Stopka/gimbal/README.md

# 3 axis gimbal
Hand held gimbal for Gopro Hero 3/4 camera with backpack display.

* [Parts](./docs/parts.md)
* [License](./LICENSE.md)

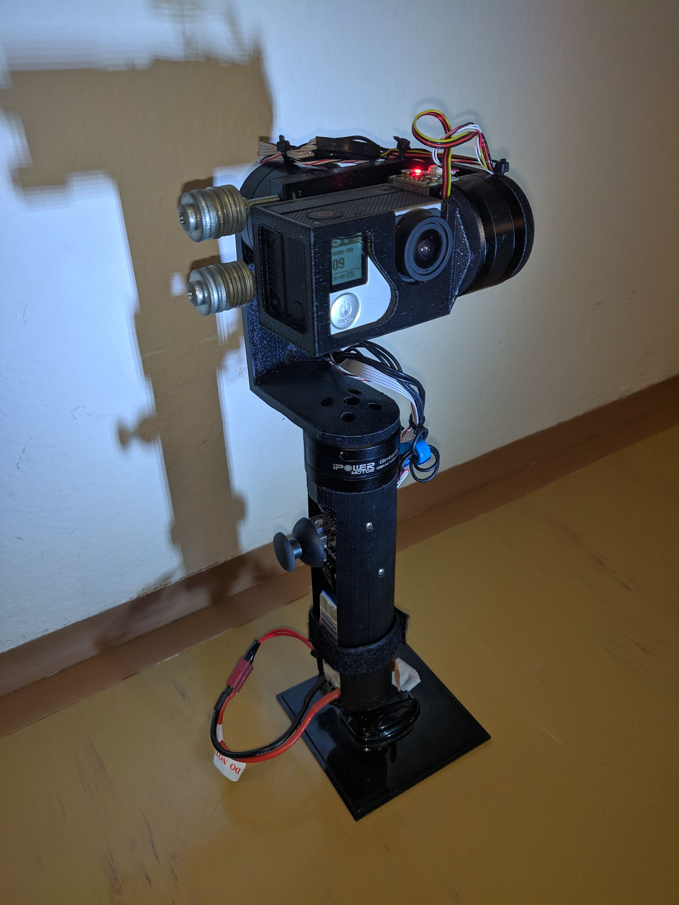
[picture p1: graphics/Image10.jpg]
