Stopka/gimbal/graphics/Image01.jpg

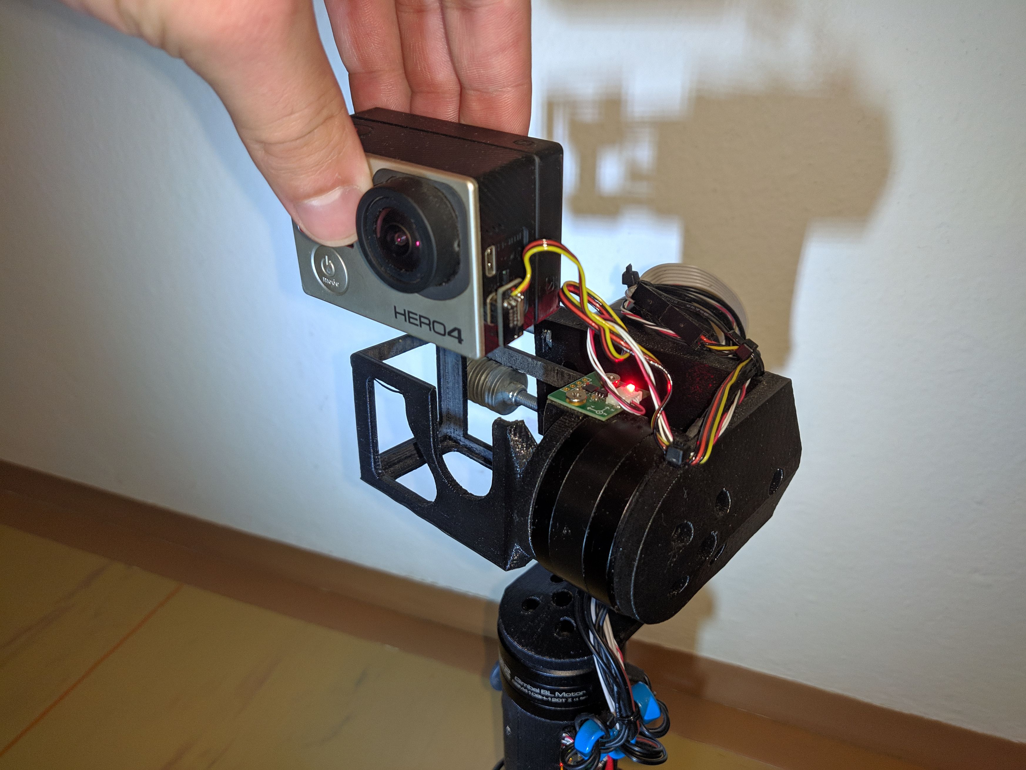
graphics/Image01.jpg
