Stopka/gimbal/graphics/Image02.jpg

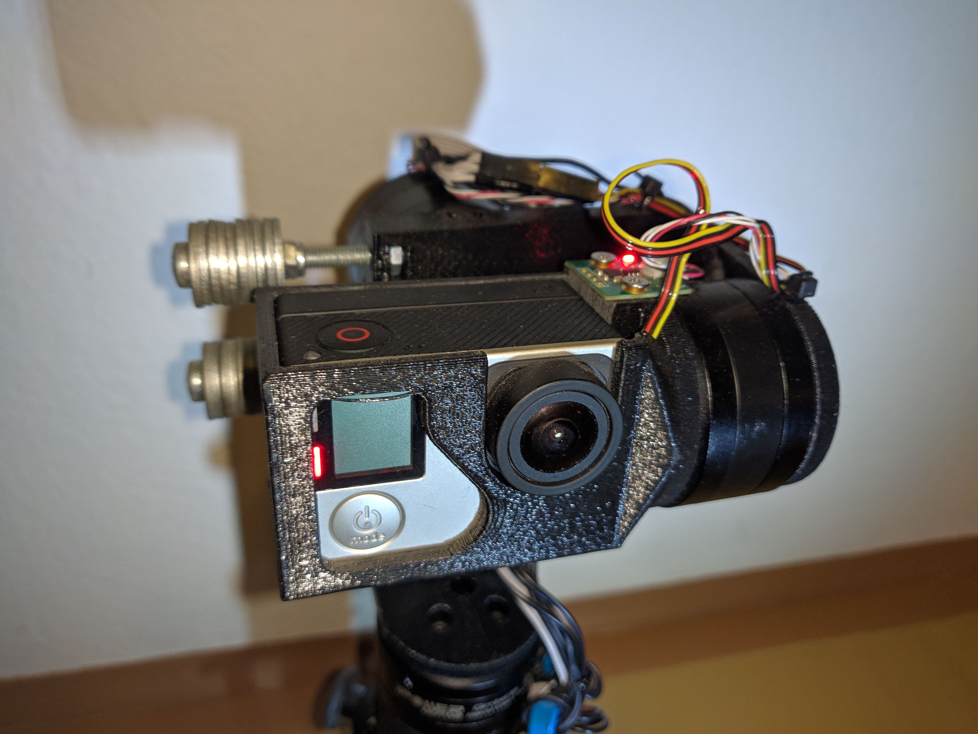
graphics/Image02.jpg
