Stopka/gimbal/graphics/Image03.jpg

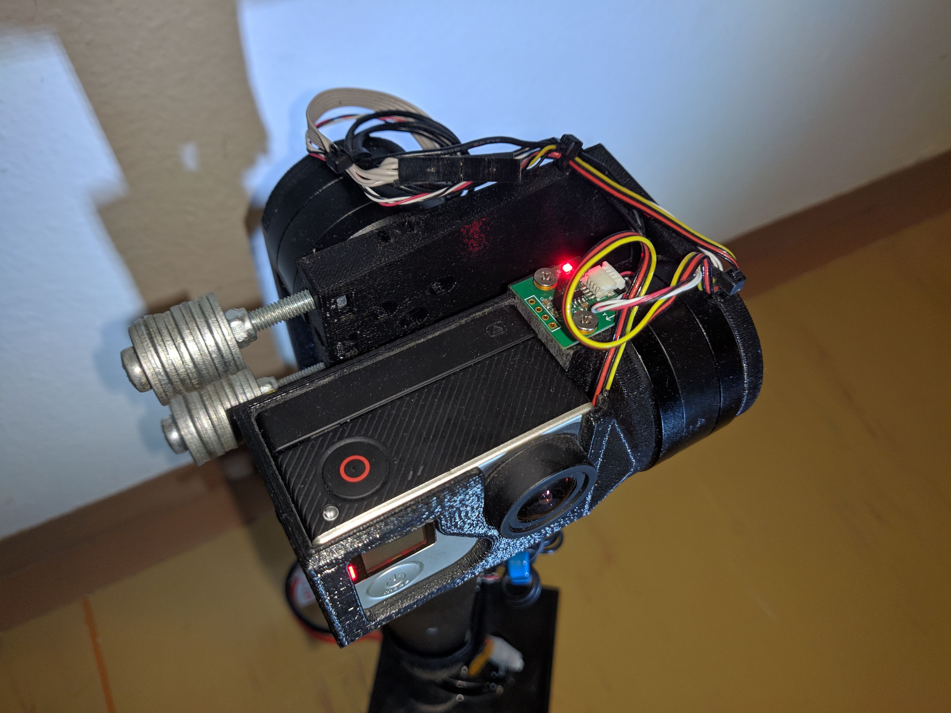
graphics/Image03.jpg
