Stopka/gimbal/graphics/Image04.jpg

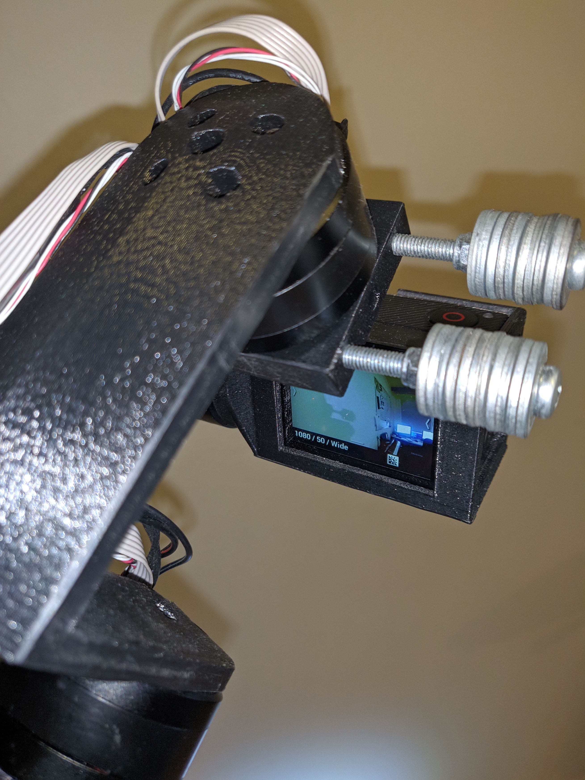
graphics/Image04.jpg
