Stopka/gimbal/graphics/Image05.jpg

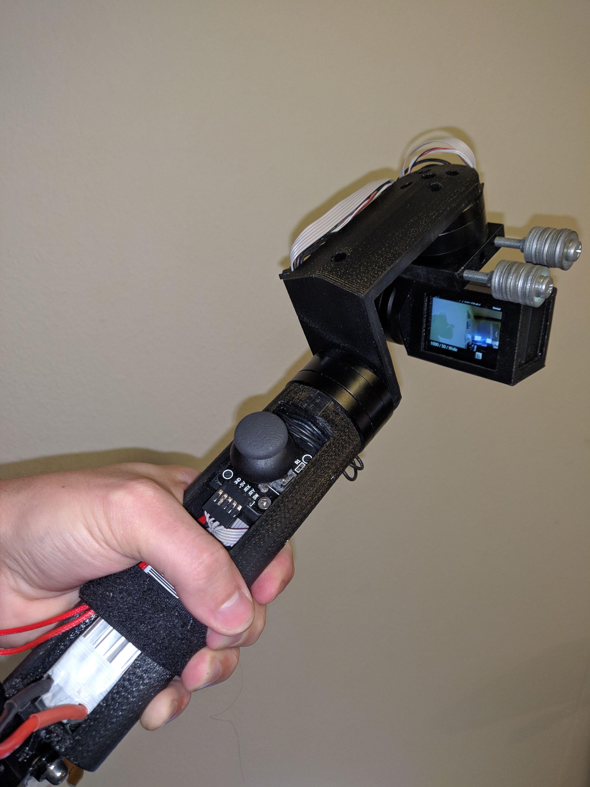
graphics/Image05.jpg
