Stopka/gimbal/graphics/Image06.jpg

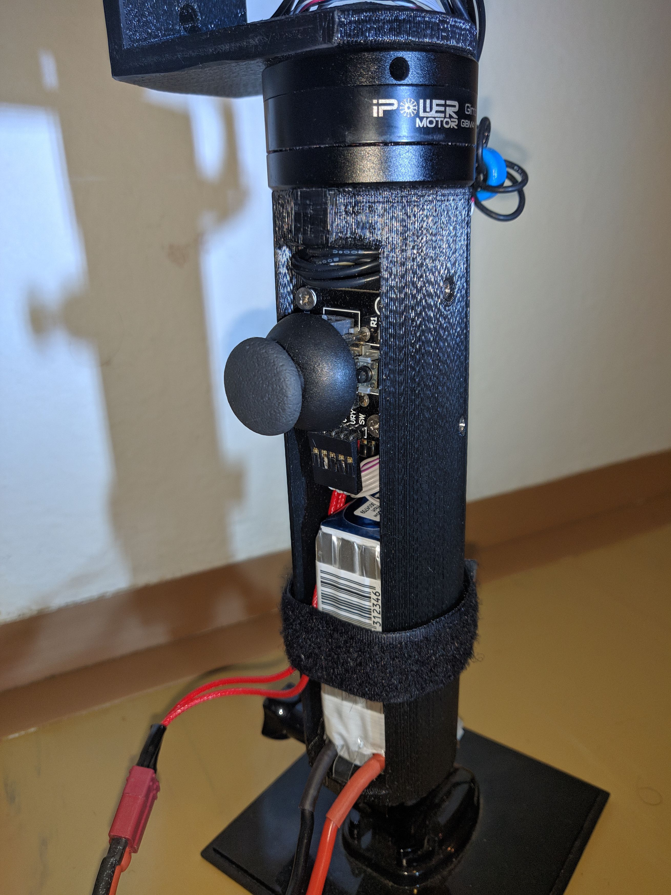
graphics/Image06.jpg
