Stopka/gimbal/graphics/Image07.jpg

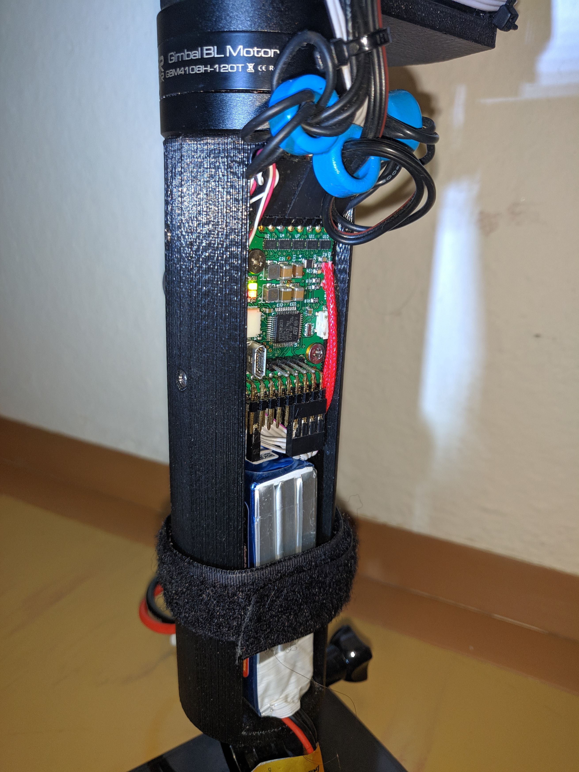
graphics/Image07.jpg
