Stopka/gimbal/graphics/Image08.jpg

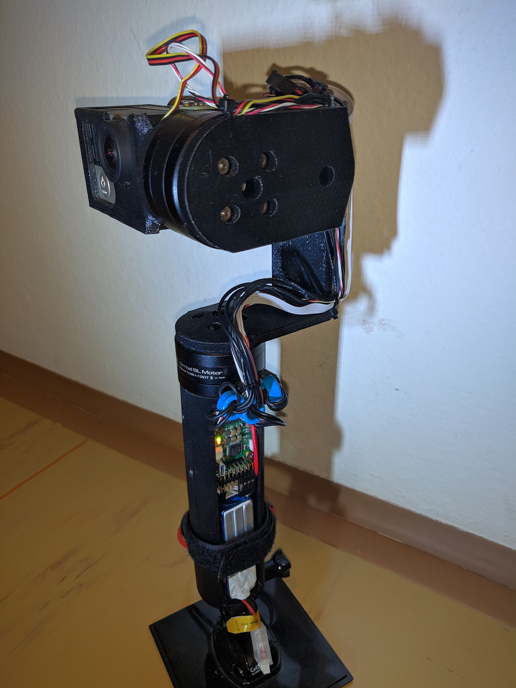
graphics/Image08.jpg
