Stopka/gimbal/graphics/Image09.jpg

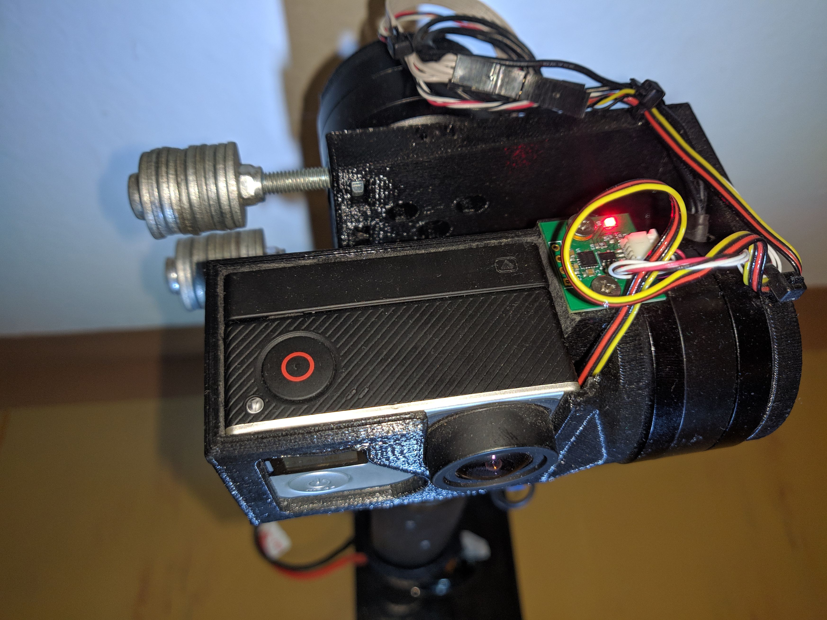
graphics/Image09.jpg
