Stopka/gimbal/graphics/render.png

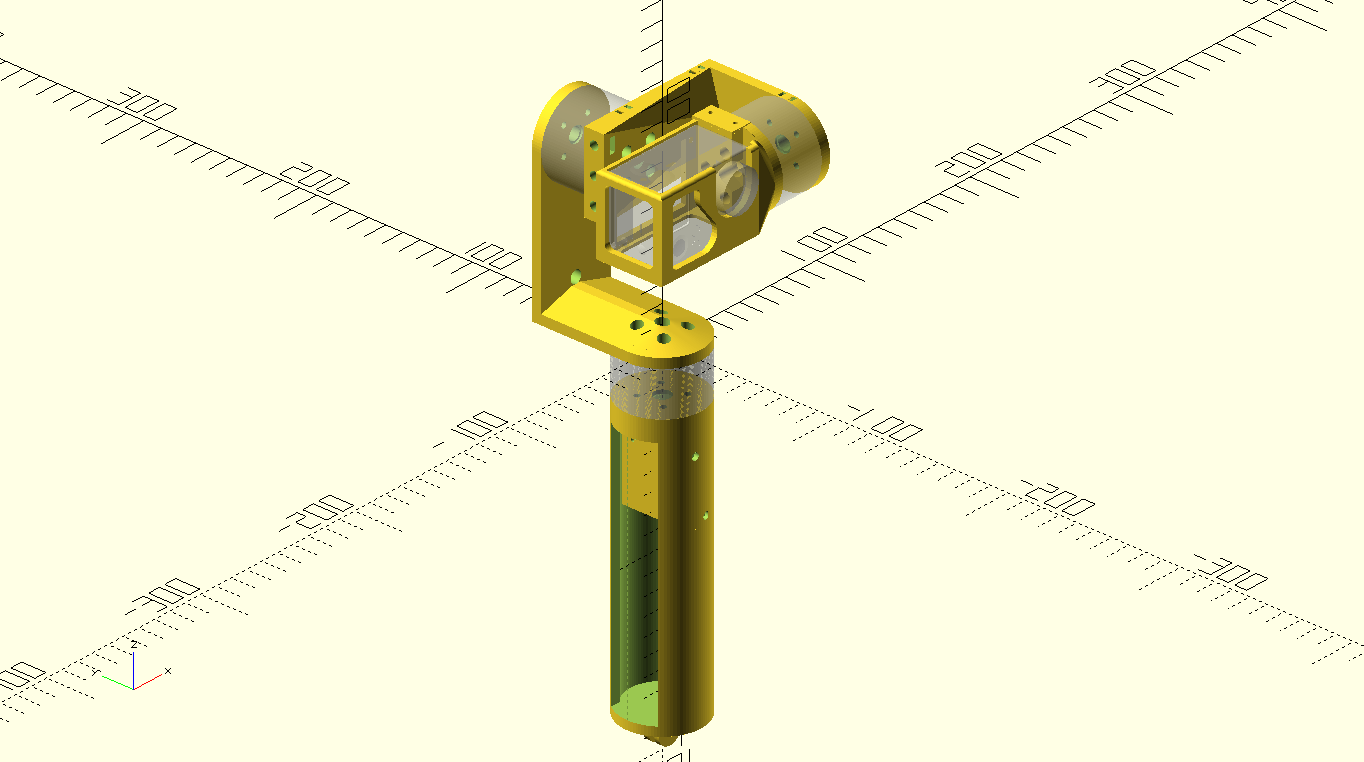
graphics/render.png
