Stopka/gimbal/docs/parts.md

# Parts

## Printable

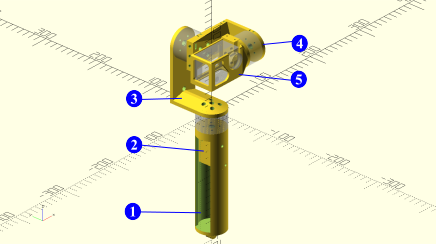
[picture p12: graphics/printed_parts.png]
Printable


1. **Handle**  
You hold this part in hand when shooting. It has cavity for mounting battery at the bottom and Handle bridge at the top. At the top side of the handle there is yaw motor mounted. At the bottom there is a gopro compatible mount.

2. **Handle bridge**
It is mounted in handle cavity. It's there to hold controller board from one side and joystick board from other side.

3. **Yaw**  
Bottom end mounts to yaw motor, top/back end mounts to roll motor. On the right side edge there are small holes for mounting cables to the frame using zip ties..

4. **Roll**  
Left/back end mounts to roll motor, right/front end mounts to pitch motor. At the top side edge there are small holes for mounting cables to the frame using zip ties. From left side edge there are holes for weight balance screws.
   
5. **Pitch**  
At the right side it mounts to pitch motor. Above motor there is a spot for mounting IMU sensor board. Left side consists of cage for mounting camera. Camera is mounted to the cage by sliding it in from top.
## Nonprintable

* Controller set (Controlloer board and IMU sensor board)  
  [SimpleBGC 32bit Tiny I2C 2-IMU Set, Revision B](https://shop.basecamelectronics.com/product/simplebgc-32bit-tiny-i2c-2-imu-set/)
* Battery  
  [LiPol Gens b-25c-1300-3s1p](https://www.gensace.de/gens-ace-1300mah-11-1v-25c-3s1p-lipo-battery-pack.html)
* Battery charger  
  [Equilibrium MINI V2 Charger 12/220V](https://www.peckamodel.cz/en/2rca0028-equilibrium-mini-v2-12-220v)
* Motors (3×)  
  [Brussless gimbal motor GBM4108H-120T Hollow Shaft](https://www.aliexpress.com/af/GBM4108H%25252d120T-Hollow-Shaft.html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)
* GoPro charging cable  
  [90 Degree USB to Video AV Output FPV Cable Power Lead Cord For GoPro HERO 3/4](https://www.ebay.com/sch/sis.html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)
* Joystick  
  [Module with X,Y axis joystick and button as Z axis (5pin)](https://www.gme.cz/modul-s-jednim-analogovym-joystickem)
* Battery connector  
  [T-plug connector](https://www.ebay.com/sch/i.html?_from=R40&_trksid=m570.l1313&_nkw=t-plug+connector&_sacat=0)
* Several cables
* Heat shrink sleeve
* Several PC pins and plastic pin covers
* Zip ties 2,5mm wide (cca 6×)
* Velcro tie for battery mount
* Mounting screws
  * Motor: M3x10 (24×)
  * Bridge: M2x10 self tapping (4×)
  * Joystick, controller & IMU: M3x10 self tapping (6×)
* Weight balance
  * Screws M5x50 (2×)
  * Pads D5 (cca 20×)
  * Locknut M5 (2×)
  * Nut M5 (2×)
