Stopka/gimbal/src/handle/handle_bridge.stl

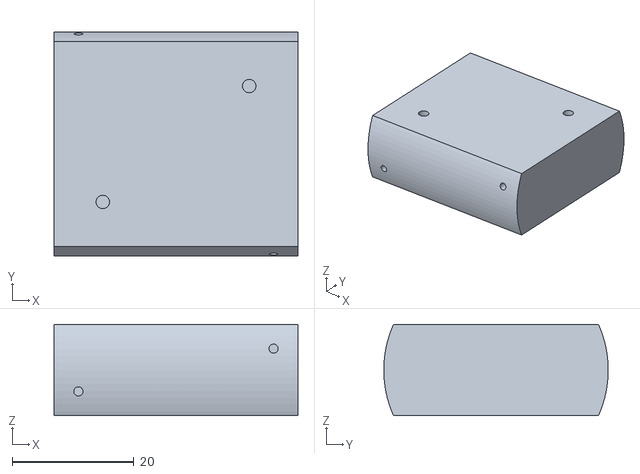
[picture p13: CAD file, 2019-02-08]
src/handle/handle_bridge.stl
40.0 x 36.8 x 15.0
