Stopka/gimbal/src/pitch/gopro3back/pitch.stl

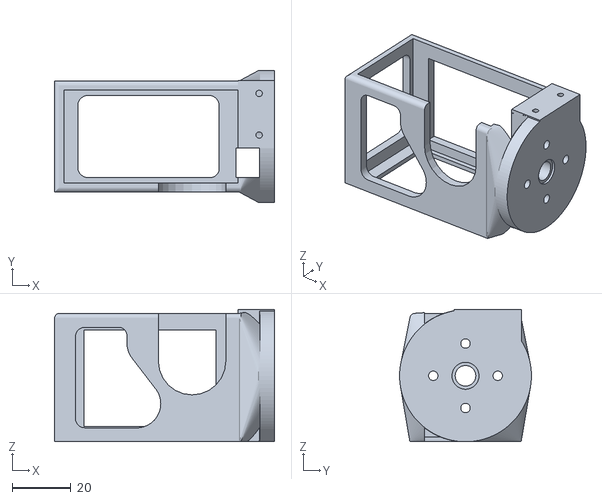
[picture p14: CAD file, 2019-02-08]
src/pitch/gopro3back/pitch.stl
75.1 x 45.0 x 45.2
