Stopka/gimbal/src/pitch_arm/pitch_arm.stl

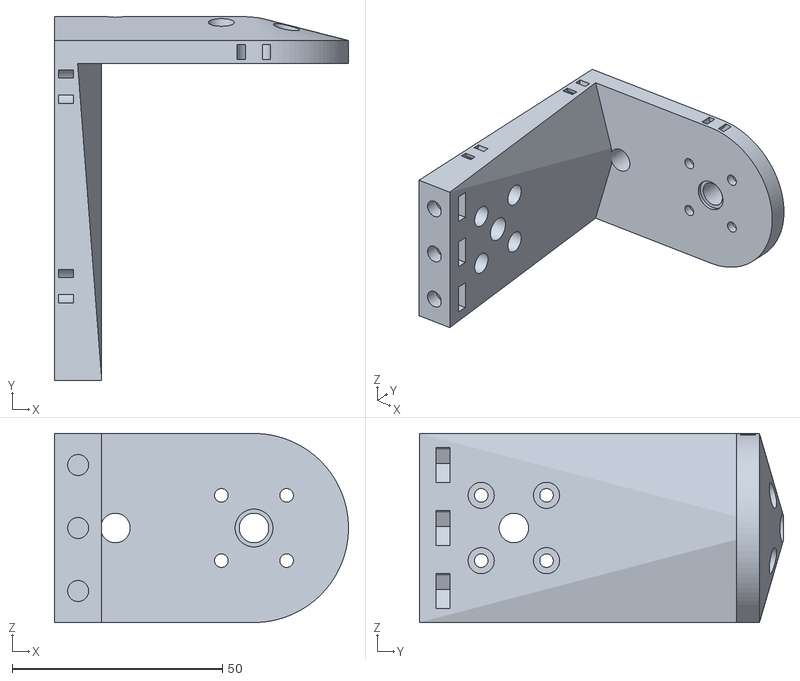
[picture p15: CAD file, 2019-02-08]
src/pitch_arm/pitch_arm.stl
70.0 x 86.8 x 45.0
