Stopka/gimbal/src/roll_arm/roll_arm2.stl

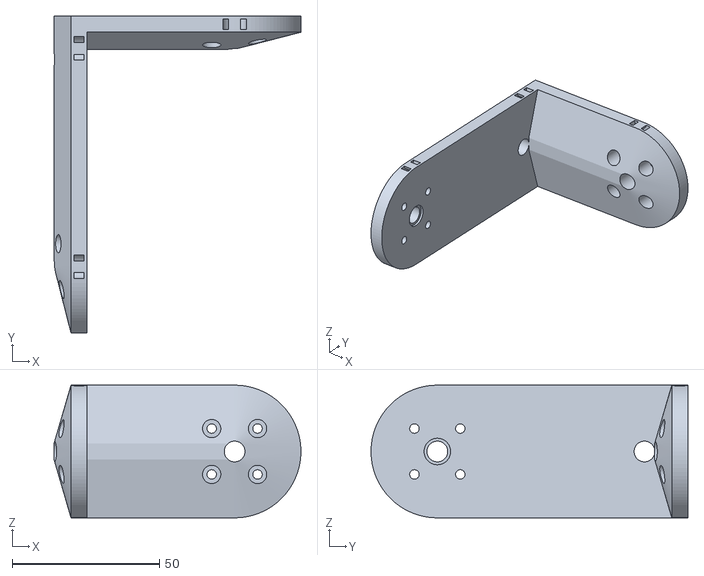
[picture p16: CAD file, 2019-02-08]
src/roll_arm/roll_arm2.stl
83.8 x 107.5 x 45.0
