Stopka/gimbal/src/handle/handle.stl

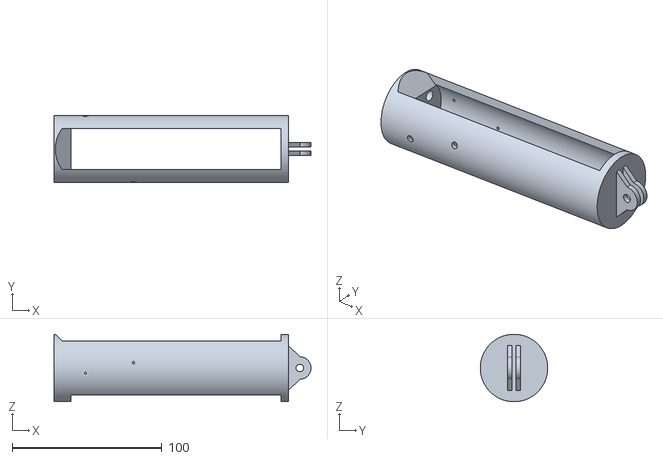
[picture p17: CAD file, 2019-02-08]
src/handle/handle.stl
171.5 x 45.0 x 45.0
