Stopka/gimbal/src/pitch/gopro3back/gopro3back.stl

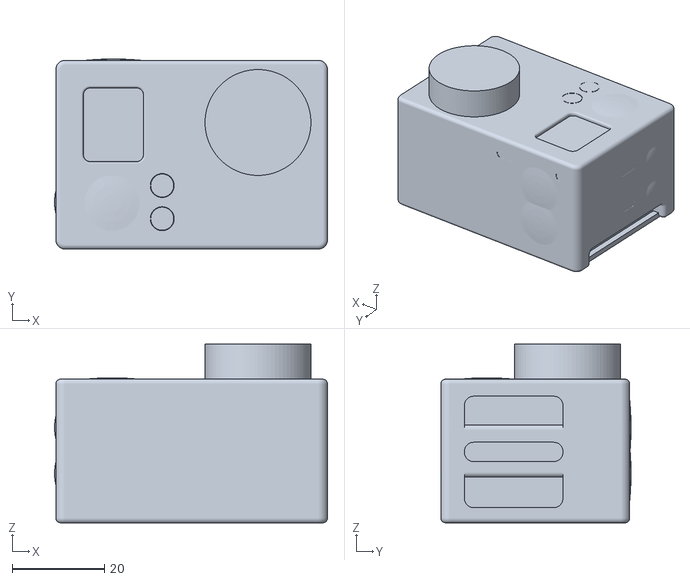
[picture p18: CAD file, 2019-02-08]
src/pitch/gopro3back/gopro3back.stl
59.3 x 41.3 x 38.8
