Stopka/gimbal/src/handle/stl_render.scad

//include <BOLTS.scad>
//include <roof.scad>
include <handle.scad>
/*
rotate([0,90,0])
handle_bridge();
/*/
rotate([0,90,0])
handle_body();
/**/
