Stopka/gimbal/src/roll/stl_render.scad

//include <BOLTS.scad>
//include <roof.scad>
include <roll.scad>;
roll();
