Stopka/gimbal/src/yaw/stl_render.scad

//include <BOLTS.scad>
//include <roof.scad>
include <yaw.scad>;
roll_mock();
yaw();
