Stopka/gimbal/src/pitch/gopro3back/stl_render.scad

//include <BOLTS.scad>
//include <roof.scad>
include <pitch.scad>

pitch();
