Stopka/gimbal/(list of files, cad)

Other CAD files:
dist/yaw.stl
dist/pitch_gopro3back.stl
dist/handle.stl
dist/handle_bridge.stl
dist/roll.stl
src/pitch/gopro3back/pitch.scad
