Stopka/gimbal/(commit log)

2019-02-09 Fixed variable conflicts in scad files, added graphics, added preview.scad
    [gopro3back.scad, gopro3back.stl, handle.scad, handle.stl, handle2.scad, handle2.stl, handle2_bridge.stl, handle_bridge.stl]
2019-02-09 Rerendered printed parts image
